TelecomParistoc/robothat/mapping.md

# Raspberry Pi pin mapping
Describes pins mapping between electronics and software.

| Name | Header pin | WiringPi pin | Small robot instance | Big robot instance |
|---|---|---|---|---|
| Button 1 | 31 | 22 | N/C | Team color |
| Button 2 | 32 | 26 | | Test / match mode|
| Button 3 | 29 | 21 | | Mode 1 / mode 2|
| LED 1 | 28 | 31 | | Green LED |
| LED 2 | 27 | 30 | | Yellow LED |
| LED 3 | 26 | 11 | | Red LED|
| Start Jack | 24 | 10 | Start | Start |
| Sensor 1 |  22 | 6 | color sensor <COLOR> | rear sides |
| Sensor 2 | 18 | 5 | color sensor <COLOR> | rear center |
| Sensor 3 | 16 | 4 | | N/C |
| Sensor 4 | 15 | 3 | | N/C |
| Sensor 5 | 13 | 2 | | front center |
| Sensor 6 | 11 | 0 | | front sides |
| Motor 1 | 12 | 1 | N/C | Shaker (PWM !) |
| Motor 2 | 7 | 7 | N/C | N/C |
