TelecomParistoc/robothat/schematic.pdf

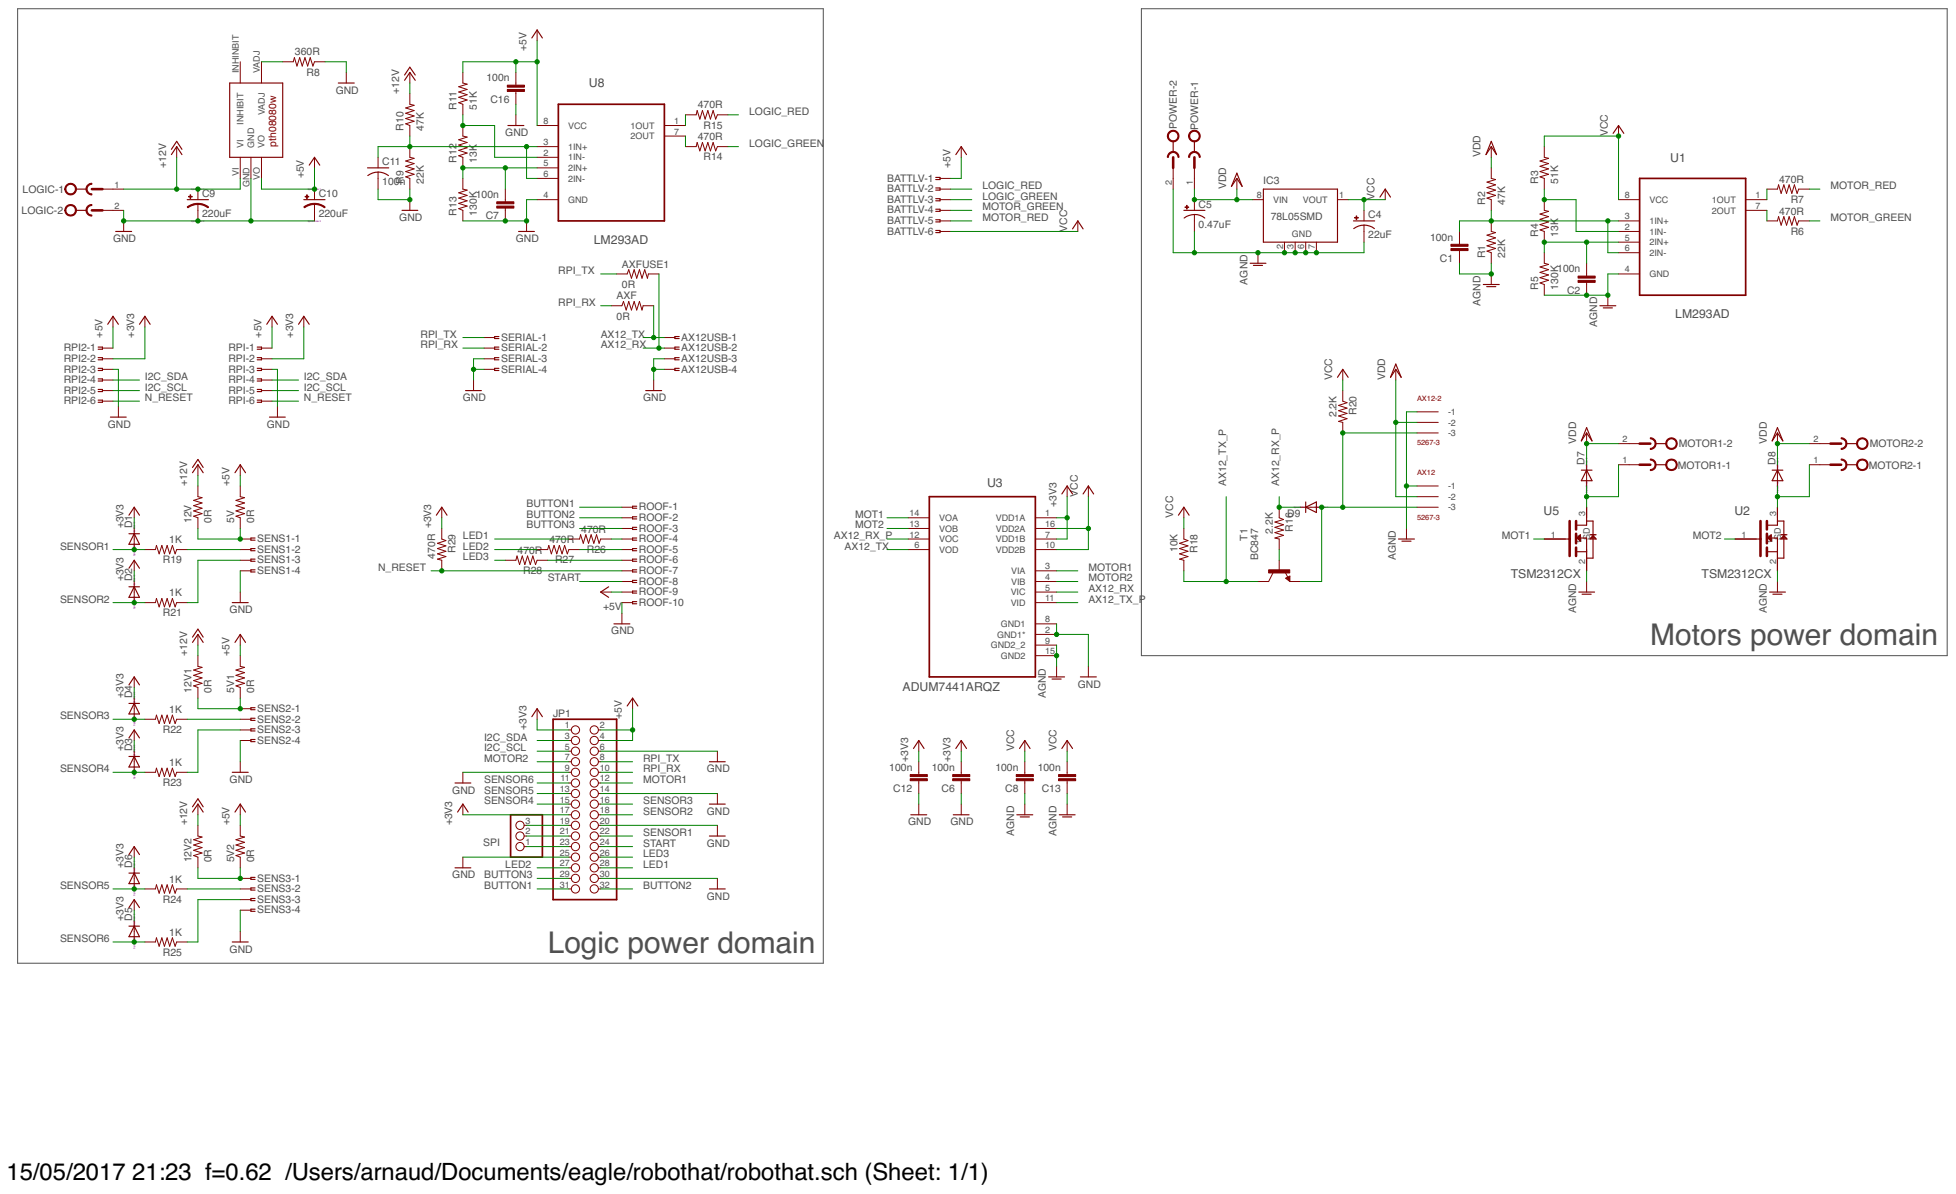
[picture p1: page 1]

VI VI GND GND

BATTLV-1 BATTLV-2 BATTLV-3 BATTLV-4 BATTLV-5 BATTLV-6

RPI-1 RPI-2 RPI-3 RPI-4 RPI-5 RPI-6

ROOF-1 ROOF-2 ROOF-3 ROOF-4 ROOF-5 ROOF-6 ROOF-7 ROOF-8 ROOF-9 ROOF-10 R26 R27 R28 R29

SpiceOrder 1 SpiceOrder 2 SpiceOrder 1 SpiceOrder 2 SpiceOrder 1 SpiceOrder 2

15/05/2017 21:23 f=0.62 /Users/arnaud/Documents/eagle/robothat/robothat.sch (Sheet: 1/1)
