TelecomParistoc/robothat/pcb-bottom.pdf

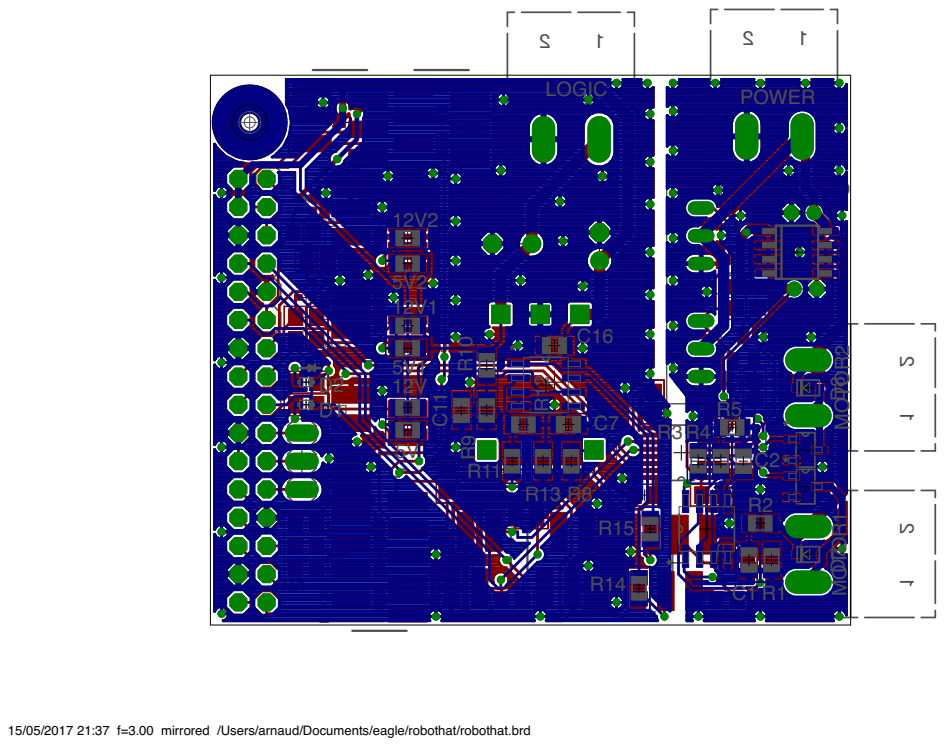
[picture p2: page 1]

15/05/2017 21:37 f=3.00 mirrored /Users/arnaud/Documents/eagle/robothat/robothat.brd
