TelecomParistoc/robothat/pcb-top.pdf

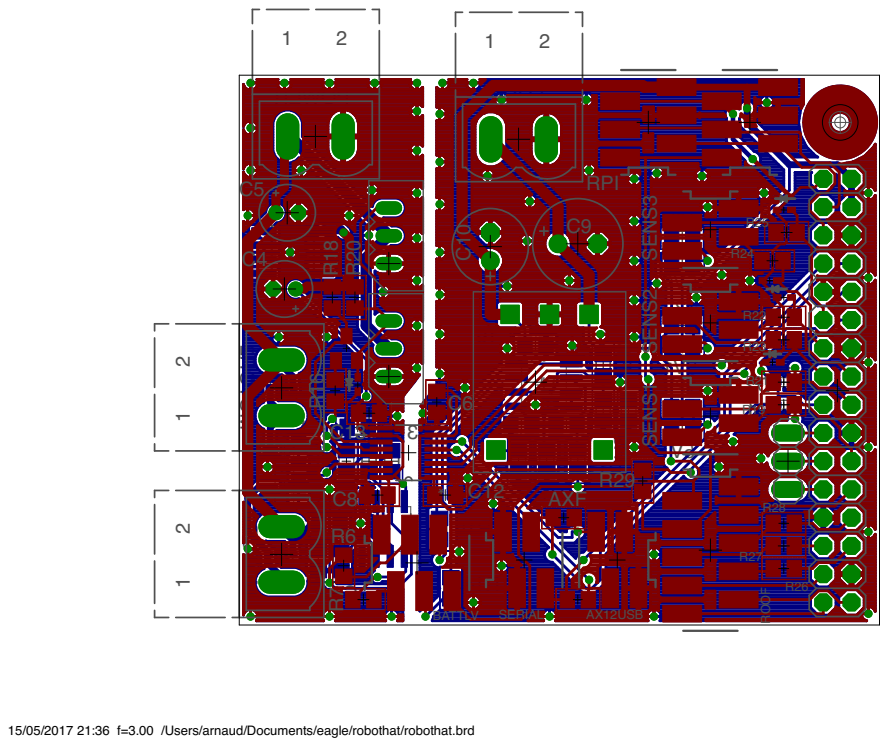
[picture p3: page 1]

15/05/2017 21:36 f=3.00 /Users/arnaud/Documents/eagle/robothat/robothat.brd
