TelecomParistoc/robothat/robothat.brd

## EAGLE design robothat.brd (2017-05-15)

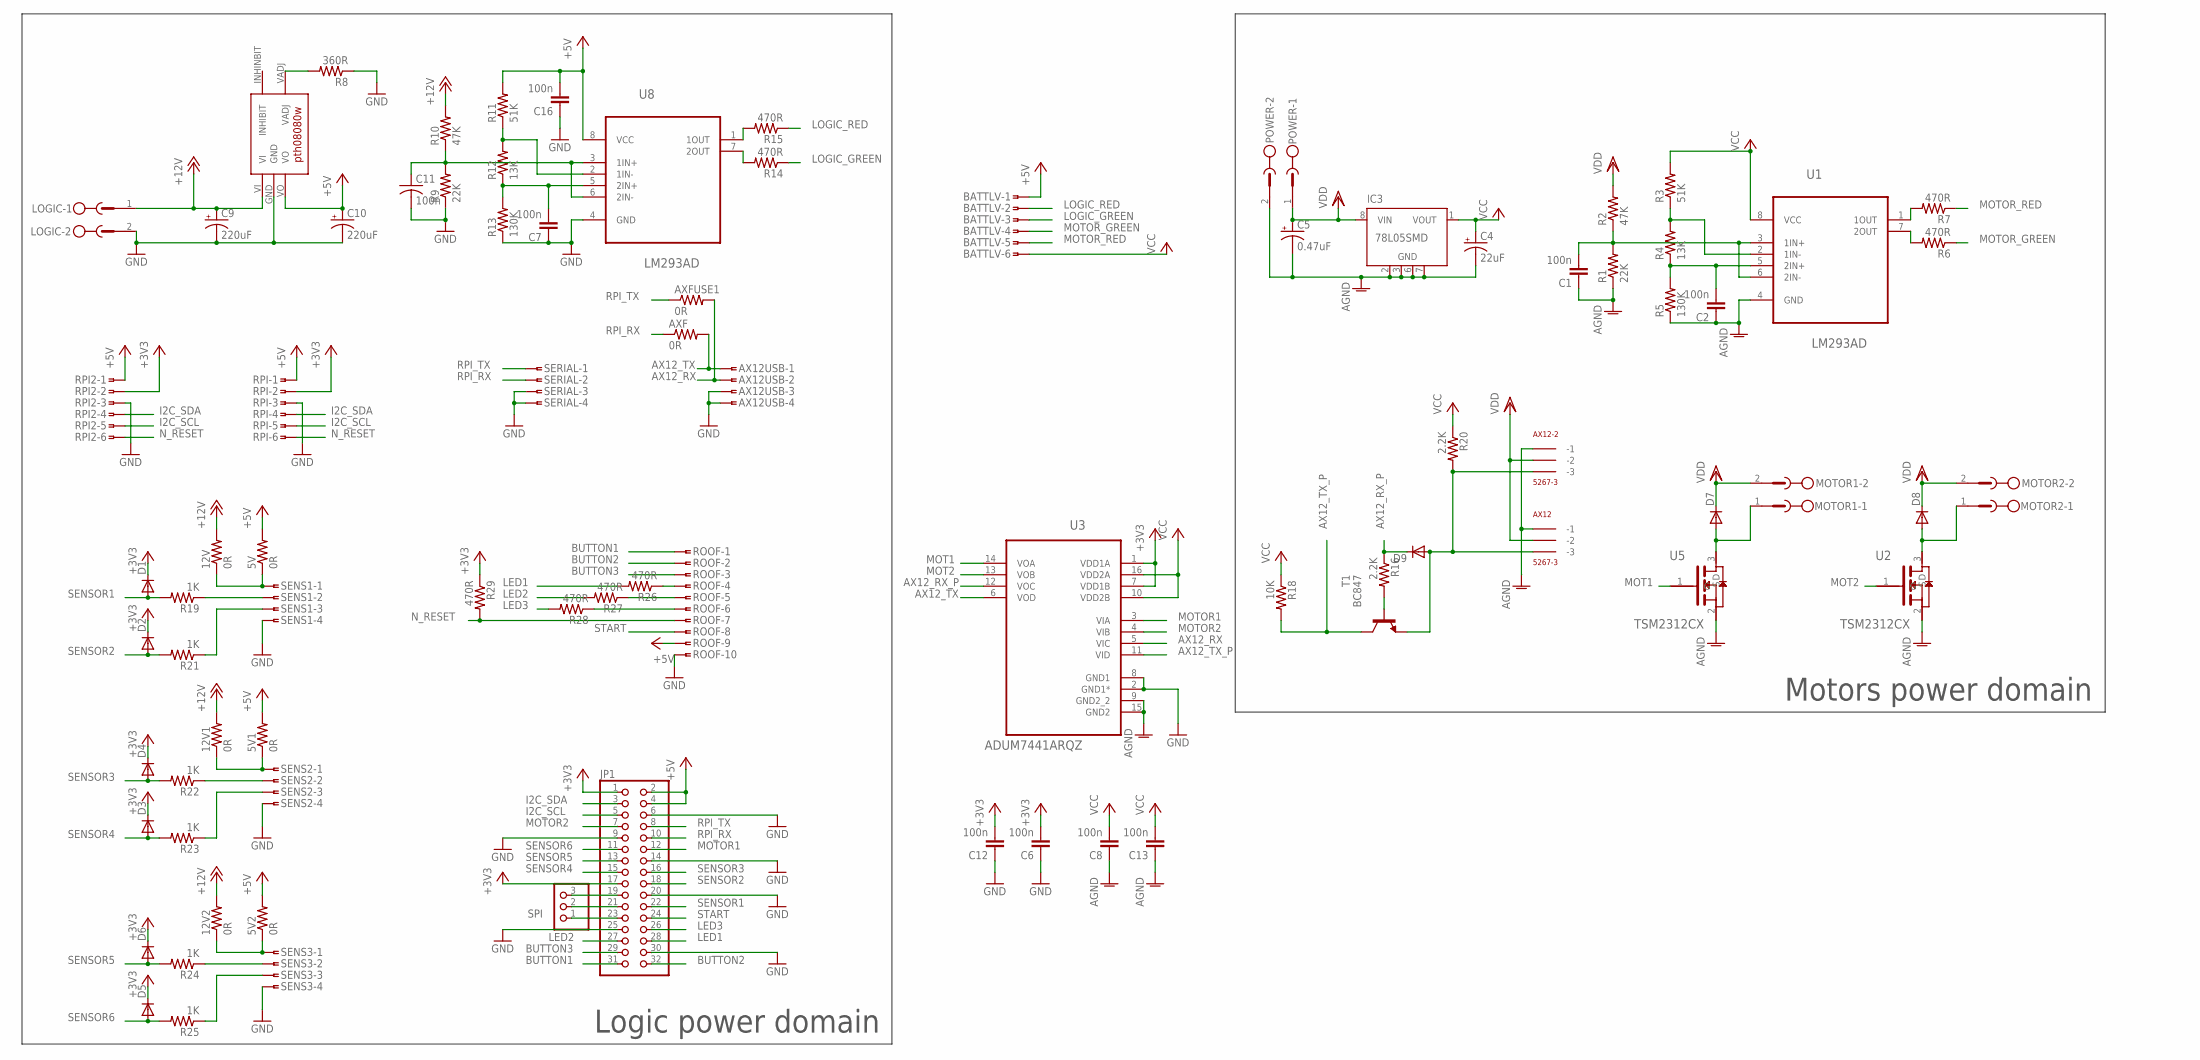
[picture p4: schematic robothat.sch]

Parts:
5V, 5V1, 5V2, 12V, 12V1, 12V2: 0R; R0805
AX12, AX12-2: 5267-3
AX12USB: SMDTOP-4; SMDTOP4
AXF: 0R; R0805
AXFUSE1: 0R; R0805
BATTLV: SMDTOP-6; SMDTOP6
C1, C2, C6, C7, C8, C11, C12, C13, C16: 100n; C0805
C4: 22uF; E2-5
C5: 0.47uF; E2-5
C9: 220uF; E3,5-8
C10: 220uF; E2,5-7
D1, D2, D3, D4, D5, D6, D9: DIODE-SOD523; SOD523
D7, D8: DIODE-SOD323-R; SOD323-R
IC3: 78L05SMD; SO08
JP1: PINHD-2X16; 2X16
LOGIC: MSTBV2
MOTOR1, MOTOR2: MSTBV2
POWER: MSTBV2
R1, R9: 22K; R0805
R2, R10: 47K; R0805
R3, R11: 51K; R0805
R4, R12: 13K; R0805
R5, R13: 130K; R0805
R6, R7, R14, R15, R26, R27, R28, R29: 470R; R0805
R8: 360R; R0805
R16, R20: 2.2K; R0805
R18: 10K; R0805
R19, R21, R22, R23, R24, R25: 1K; R0805
ROOF: SMDTOP-10; SMDTOP10
RPI, RPI2: SMDTOP-6; SMDTOP6
SENS1, SENS2, SENS3: SMDTOP-4; SMDTOP4
SERIAL: SMDTOP-4; SMDTOP4
SPI: PINHD-1X3; 1X03
T1: BC847; SOT23
U1, U8: LM293AD; SOIC127P600X175-8N
U2, U5: TSM2312CX; SOT95P280X130-3N
U3: ADUM7441ARQZ; SOP64P600X175-16N
U$2: REGUL_PTH

Connections:
+3V3: C6.2, C12.2, D1.C, D2.C, D3.C, D4.C, D5.C, D6.C, JP1.1, JP1.17, R29.1, RPI.2, RPI2.2, U3.1 (VDD1A), U3.7 (VDD1B)
+5V: 5V.2, 5V1.2, 5V2.2, BATTLV.1, C10.+, C16.2, JP1.2, JP1.4, R11.2, ROOF.9, RPI.1, RPI2.1, U8.8 (VCC), U$2.VO
+12V: 12V.2, 12V1.2, 12V2.2, C9.+, LOGIC.1, R10.2, U$2.VI
AGND: AX12.P$1 (-1), AX12-2.P$1 (-1), C1.1, C2.1, C4.-, C5.-, C8.1, C13.1, IC3.2 (GND), IC3.3 (GND), IC3.6 (GND), IC3.7 (GND), POWER.2, R1.1, R5.1, U1.4 (GND), U2.2 (S), U3.9 (GND2_2), U3.15 (GND2), U5.2 (S)
AX12_RX: AX12USB.2, AXFUSE1.2, U3.5 (VIC)
AX12_RX_P: D9.C, R16.1, U3.12 (VOC)
AX12_TX: AX12USB.1, AXF.2, U3.6 (VOD)
AX12_TX_P: R18.2, T1.3 (C), U3.11 (VID)
BUTTON1: JP1.31, ROOF.1
BUTTON2: JP1.32, ROOF.2
BUTTON3: JP1.29, ROOF.3
GND: AX12USB.3, AX12USB.4, C6.1, C7.1, C9.-, C10.-, C11.2, C12.1, C16.1, JP1.6, JP1.9, JP1.14, JP1.20, JP1.25, JP1.30, LOGIC.2, R8.1, R9.1, R13.1, ROOF.10, RPI.3, RPI2.3, SENS1.4, SENS2.4, SENS3.4, SERIAL.3, SERIAL.4, U3.2 (GND1*), U3.8 (GND1), U8.4 (GND), U$2.GND
I2C_SCL: JP1.5, RPI.5, RPI2.5
I2C_SDA: JP1.3, RPI.4, RPI2.4
LED1: JP1.28, R26.2
LED2: JP1.27, R27.2
LED3: JP1.26, R28.2
LOGIC_GREEN: BATTLV.3, R14.1
LOGIC_RED: BATTLV.2, R15.1
MOT1: U3.14 (VOA), U5.1 (G)
MOT2: U2.1 (G), U3.13 (VOB)
MOTOR1: JP1.12, U3.3 (VIA)
MOTOR2: JP1.7, U3.4 (VIB)
MOTOR_GREEN: BATTLV.4, R6.1
MOTOR_RED: BATTLV.5, R7.1
unnamed: R7.2, U1.1 (1OUT)
unnamed: D7.A, MOTOR1.1, U5.3 (D)
unnamed: R6.2, U1.7 (2OUT)
unnamed: D8.A, MOTOR2.1, U2.3 (D)
unnamed: C1.2, R1.2, R2.1, U1.3 (1IN+), U1.6 (2IN-)
unnamed: R3.1, R4.2, U1.2 (1IN-)
unnamed: C2.2, R4.1, R5.2, U1.5 (2IN+)
unnamed: 5V.1, 12V.1, SENS1.1
unnamed: 5V1.1, 12V1.1, SENS2.1
unnamed: R22.1, SENS2.2
unnamed: R19.1, SENS1.2
unnamed: R8.2, U$2.VADJ
unnamed: R15.2, U8.1 (1OUT)
unnamed: R14.2, U8.7 (2OUT)
unnamed: R21.1, SENS1.3
unnamed: C11.1, R9.2, R10.1, U8.3 (1IN+), U8.6 (2IN-)
unnamed: R11.1, R12.2, U8.2 (1IN-)
unnamed: C7.2, R12.1, R13.2, U8.5 (2IN+)
unnamed: R23.1, SENS2.3
unnamed: R16.2, T1.1 (B)
unnamed: AX12.P$3 (-3), AX12-2.P$3 (-3), D9.A, R20.2, T1.2 (E)
unnamed: 5V2.1, 12V2.1, SENS3.1
unnamed: R24.1, SENS3.2
unnamed: R25.1, SENS3.3
unnamed: R27.1, ROOF.5
unnamed: R26.1, ROOF.4
unnamed: R28.1, ROOF.6
unnamed: JP1.19, SPI.3
unnamed: JP1.21, SPI.2
unnamed: JP1.23, SPI.1
N_RESET: R29.2, ROOF.7, RPI.6, RPI2.6
RPI_RX: AXF.1, JP1.10, SERIAL.2
RPI_TX: AXFUSE1.1, JP1.8, SERIAL.1
SENSOR1: D1.A, JP1.22, R19.2
SENSOR2: D2.A, JP1.18, R21.2
SENSOR3: D4.A, JP1.16, R22.2
SENSOR4: D3.A, JP1.15, R23.2
SENSOR5: D6.A, JP1.13, R24.2
SENSOR6: D5.A, JP1.11, R25.2
START: JP1.24, ROOF.8
VCC: BATTLV.6, C4.+, C8.2, C13.2, IC3.1 (VOUT), R3.2, R18.1, R20.1, U1.8 (VCC), U3.10 (VDD2B), U3.16 (VDD2A)
VDD: AX12.P$2 (-2), AX12-2.P$2 (-2), C5.+, D7.C, D8.C, IC3.8 (VIN), MOTOR1.2, MOTOR2.2, POWER.1, R2.2

Notes on the sheet:
Logic power domain
Motors power domain

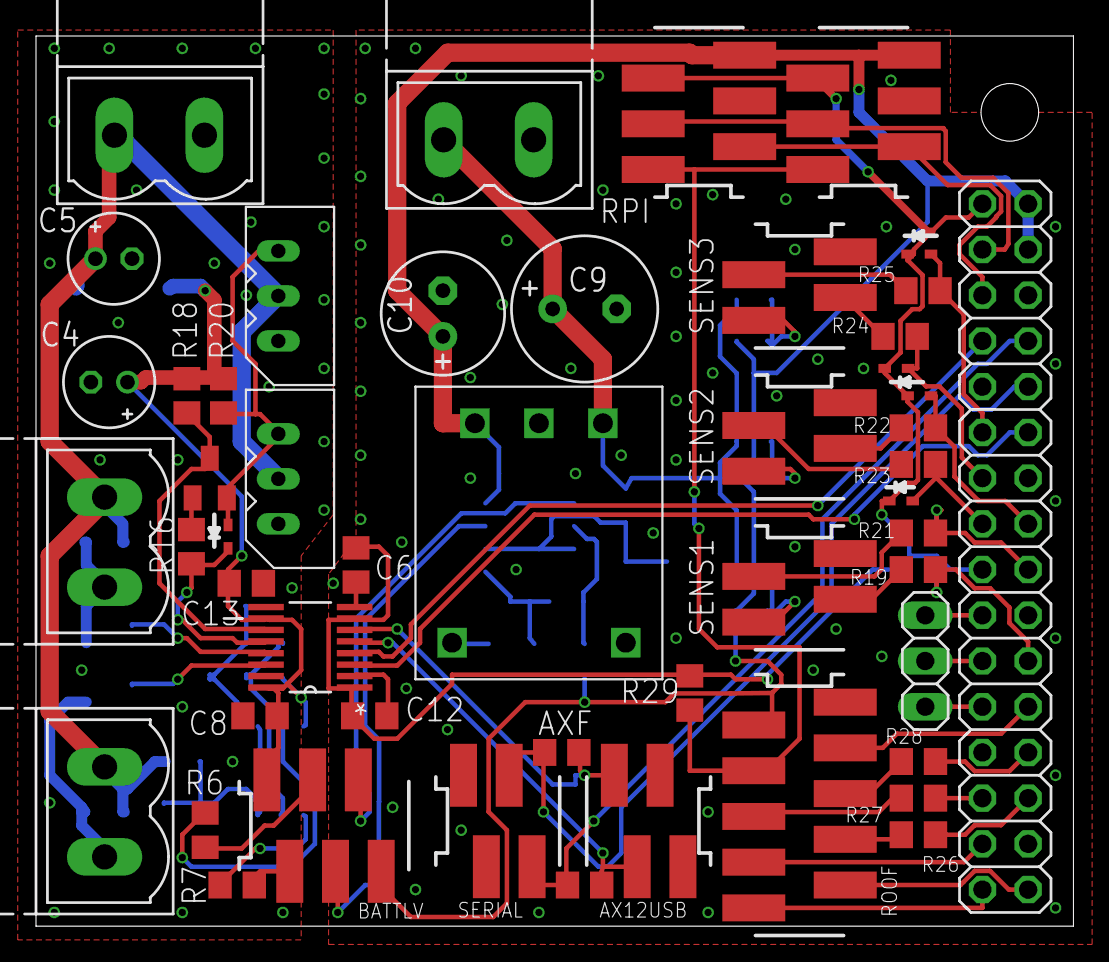
[picture p5: board robothat.brd from above]

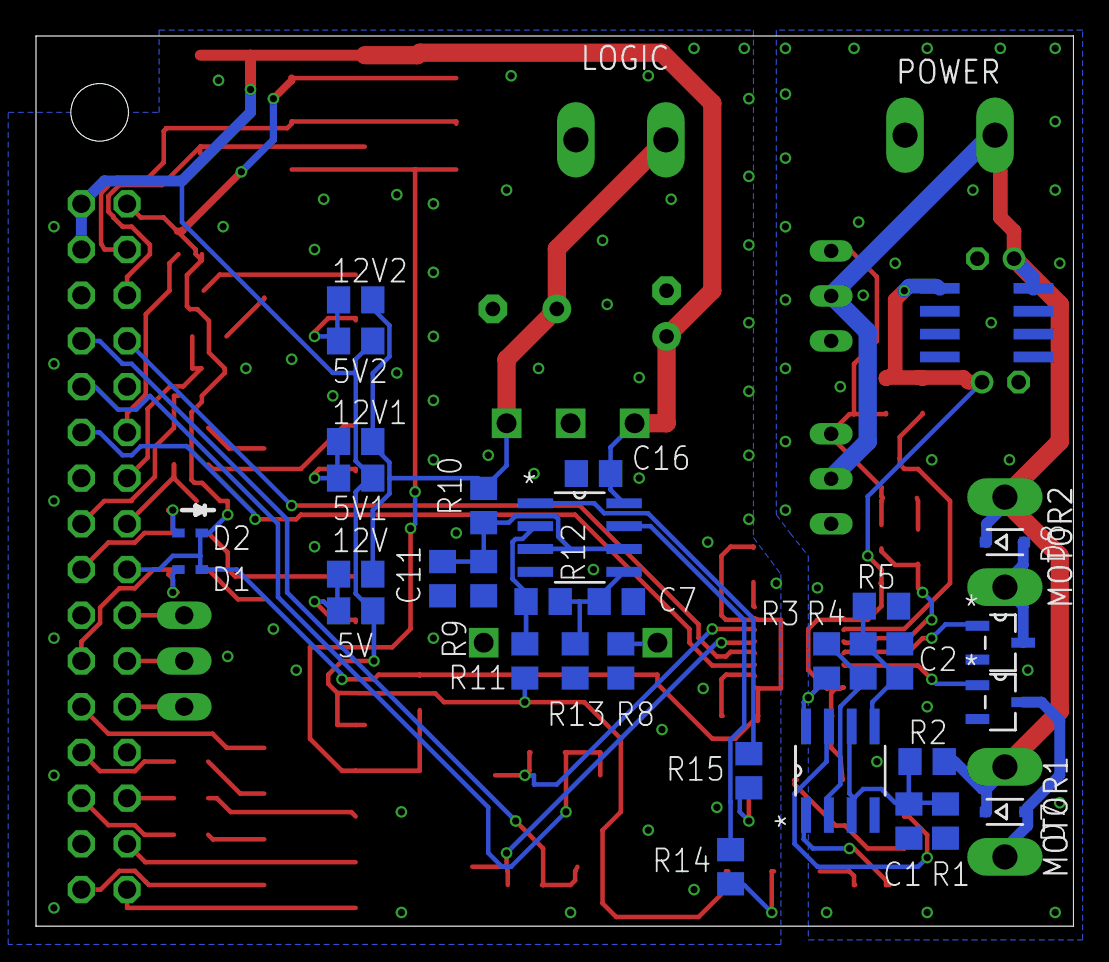
[picture p6: board robothat.brd from below]

Board: 2 copper layers, 57.6 x 49.5 mm, 83 parts (33 on the bottom side), 67 nets.
