TelecomParistoc/robothat/(commit log)

2017-04-26 schematic and beginning of place
    [robothat.brd, robothat.sch]
2017-04-26 finished first place
    [robothat.brd, robothat.sch]
2017-05-02 routing and silkscreen done
    [robothat.brd, robothat.sch]
2017-05-15 added schematic and pcb in pdf, added BOM
    [bom.csv, robothat.brd]
2017-05-16 added farnell refs
    [bom.csv]
